TobleMiner/usb-pd-poe-extractor/USB-PD-PoE.kicad_pcb

## KiCad design USB-PD-PoE.kicad_pcb (2021-04-19)

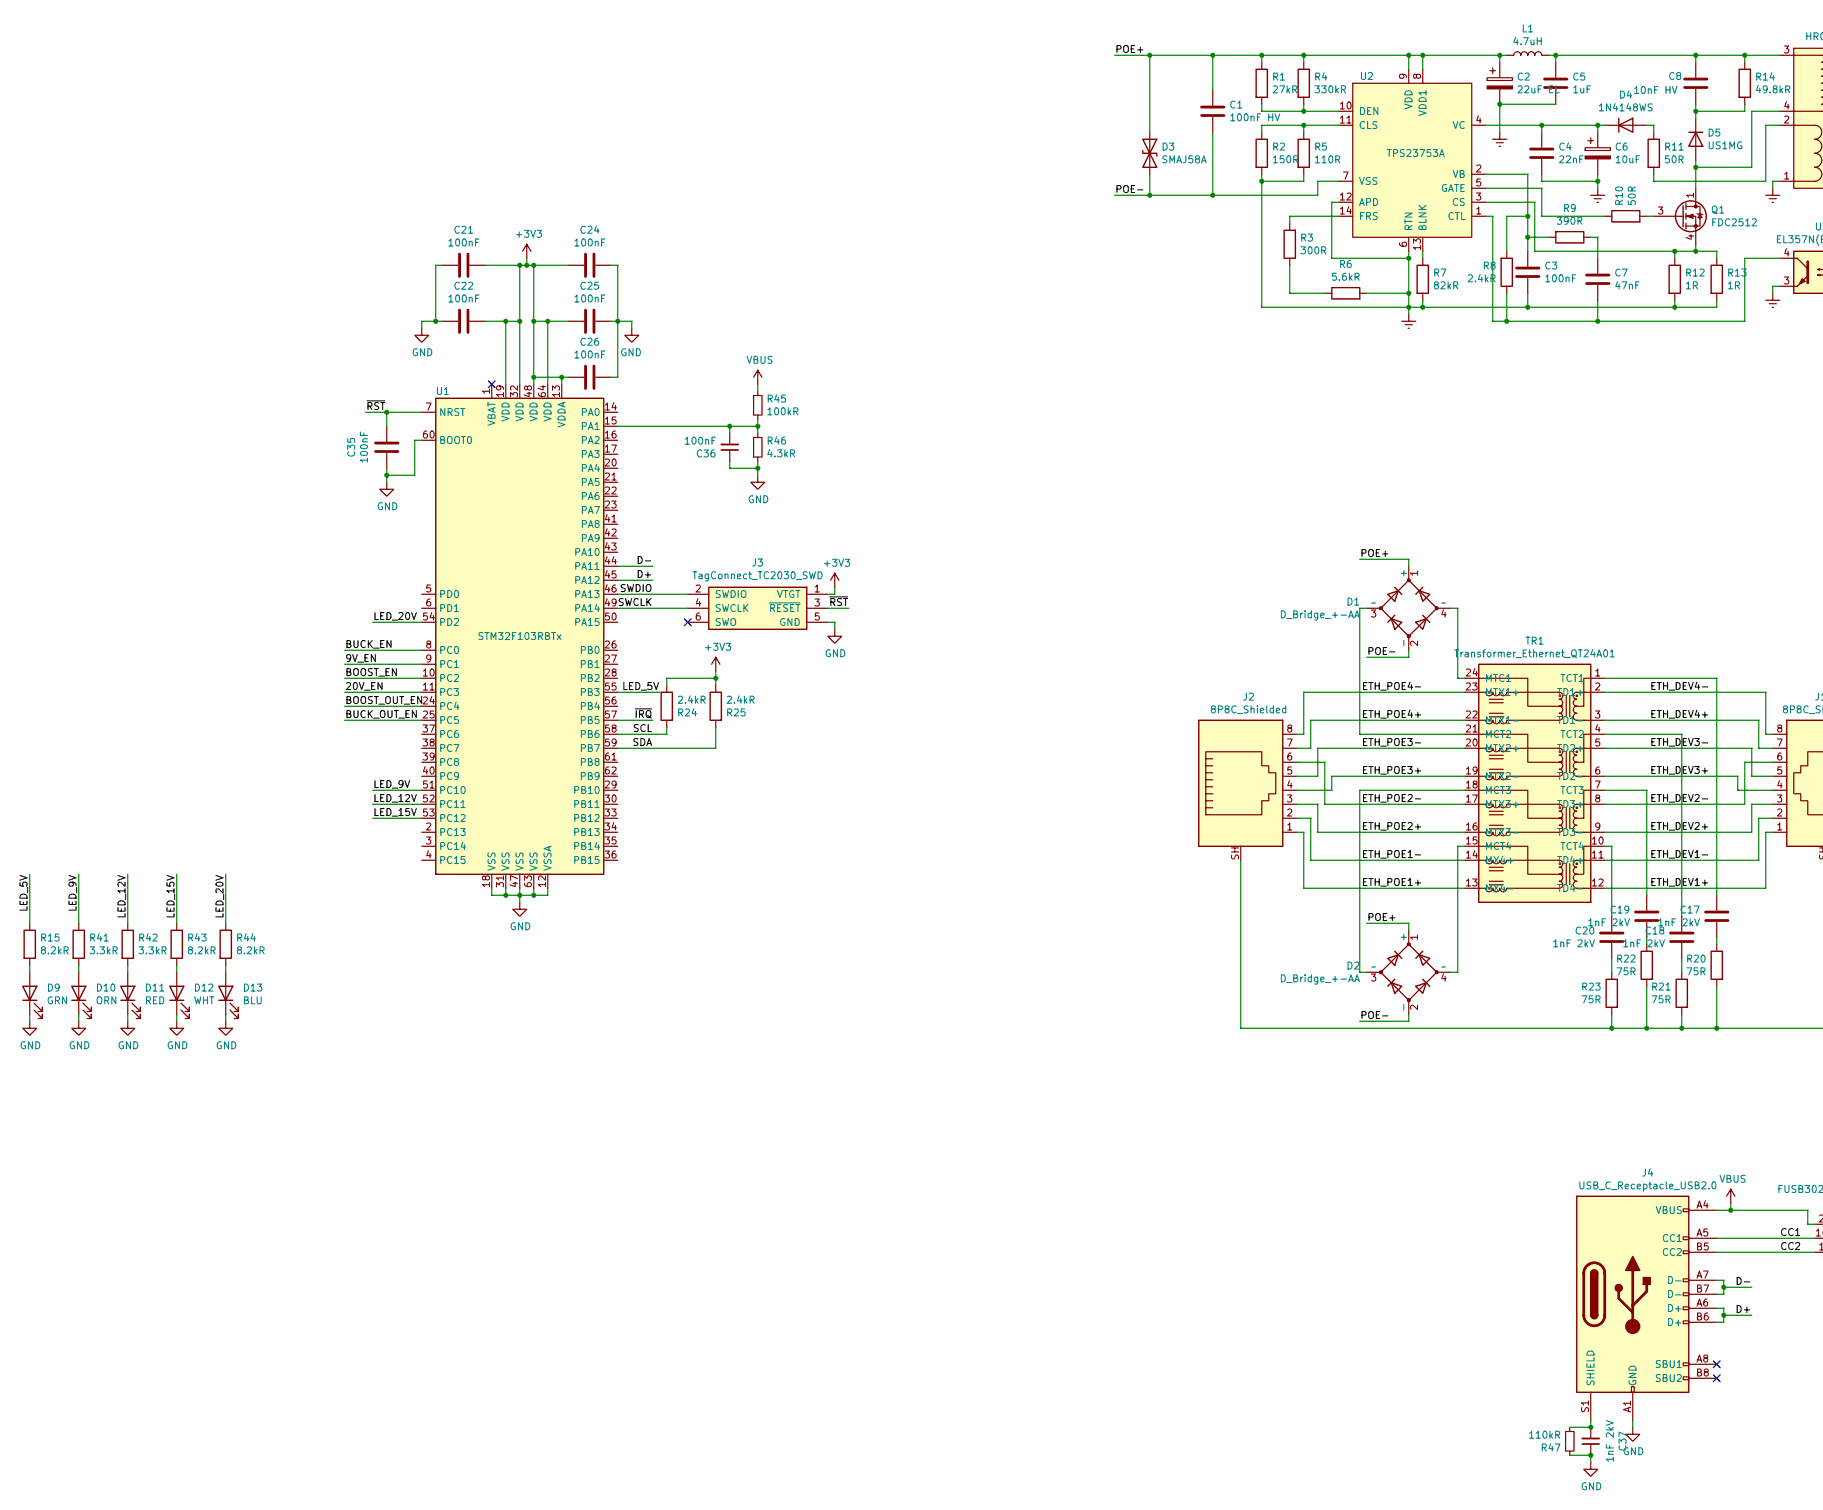
[picture p1: schematic USB-PD-PoE.sch, part in row 1, column 1]

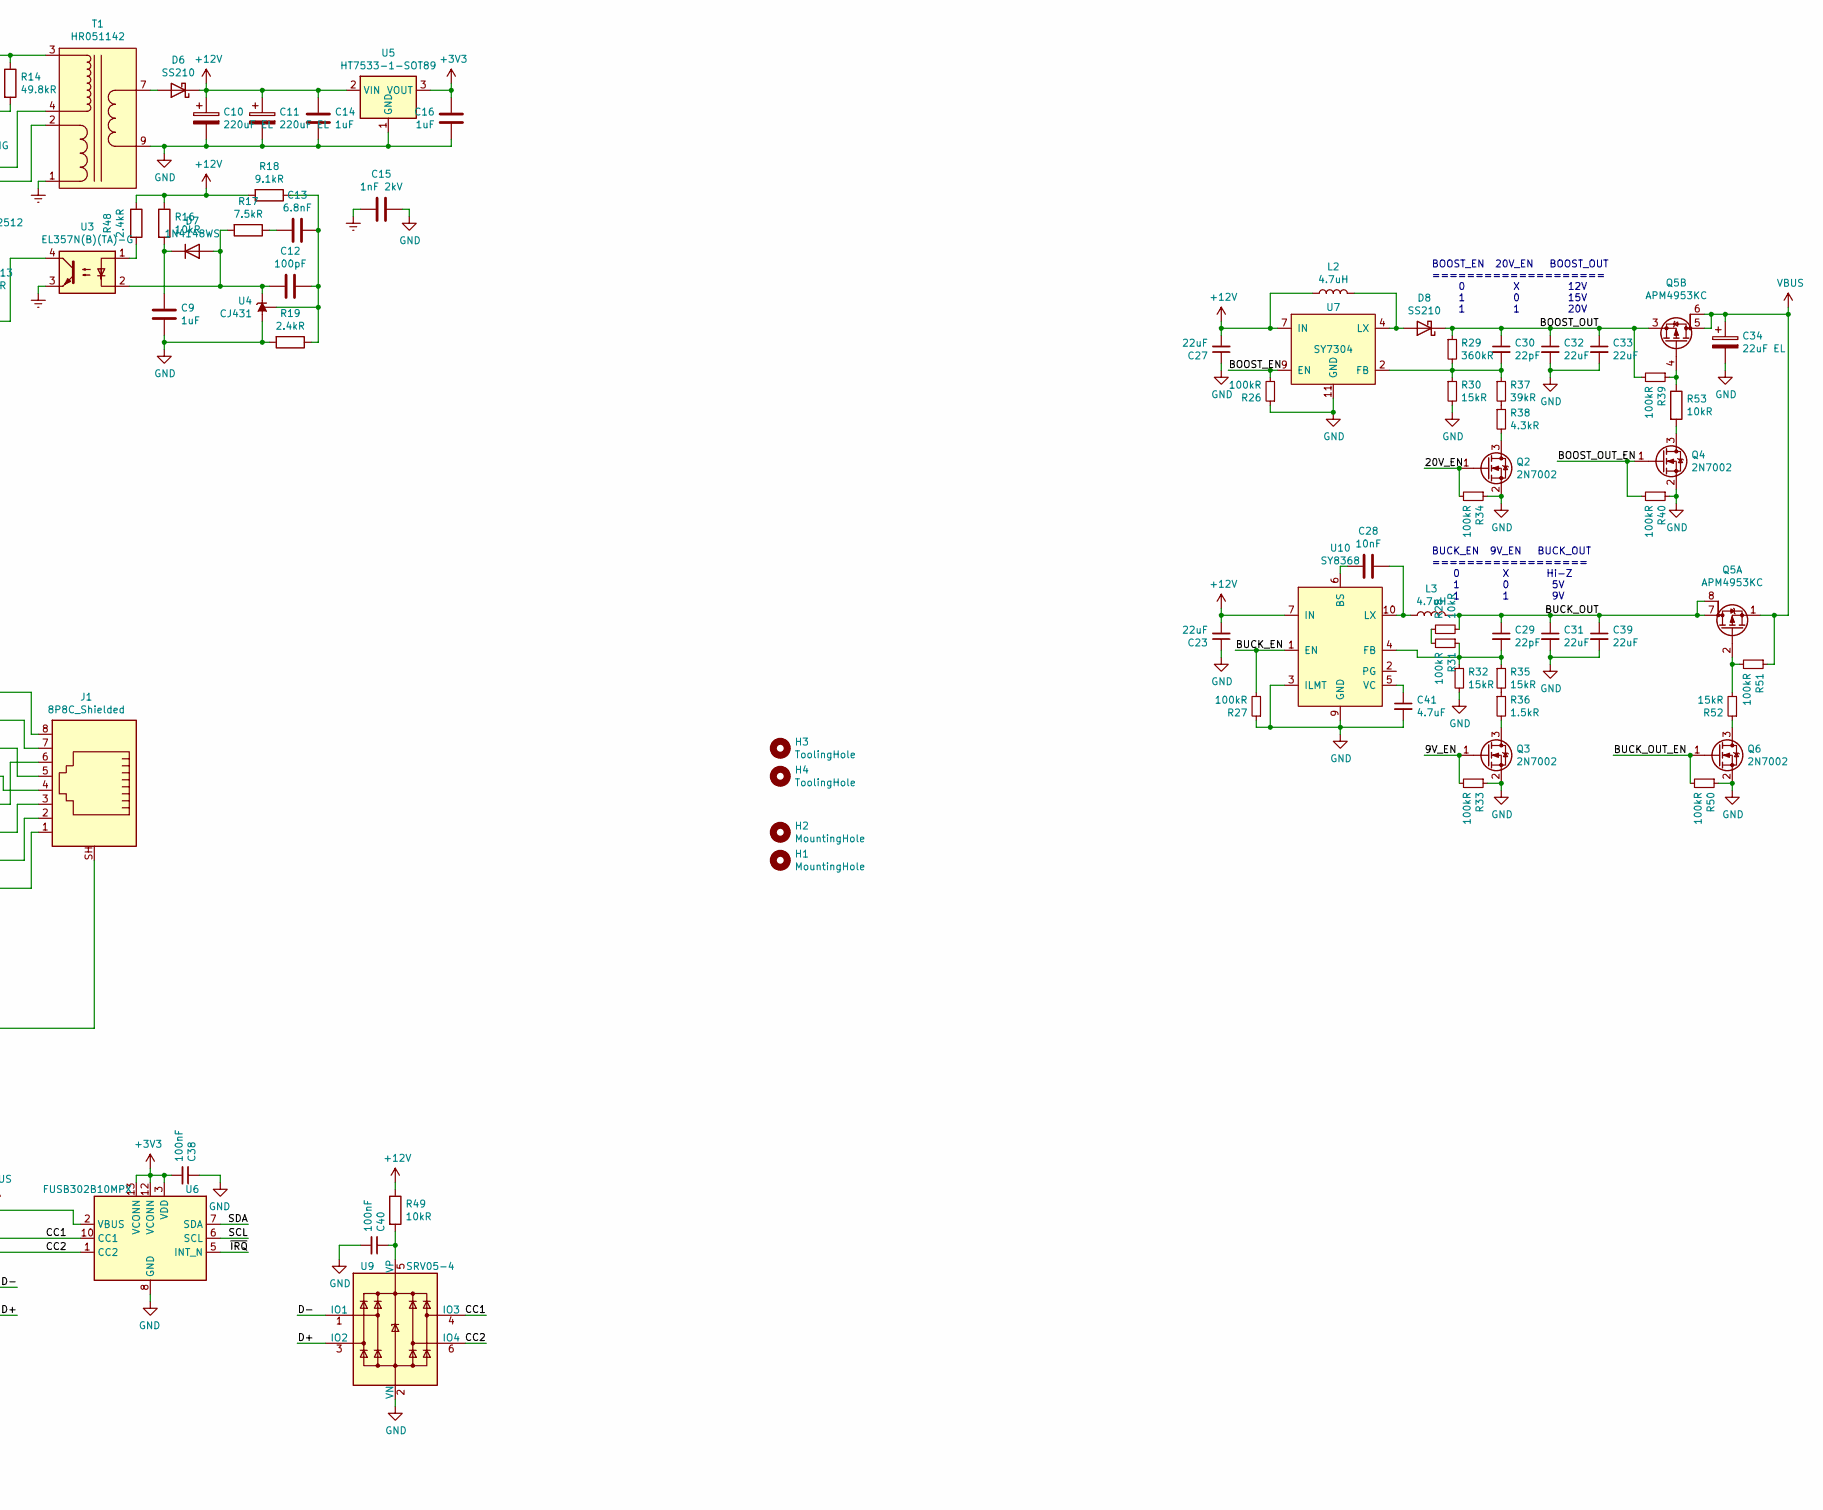
[picture p2: schematic USB-PD-PoE.sch, part in row 1, column 2]

Parts:
C1: 100nF HV; C_1206_3216Metric; LCSC C73745
C2, C34: 22uF EL; CP_Elec_6.3x7.7; LCSC C249868
C3, C21, C22, C24, C25, C26, C35, C36, C38, C40: 100nF; C_0402_1005Metric; LCSC C1525
C4: 22nF; C_0402_1005Metric; LCSC C1532
C5: 1uF; C_1206_3216Metric; LCSC C13832
C6: 10uF; CP_EIA-3216-10_Kemet-I; LCSC C7171
C7: 47nF; C_0603_1608Metric; LCSC C1622
C8: 10nF HV; C_0805_2012Metric; LCSC C18741
C9, C14, C16: 1uF; C_0402_1005Metric; LCSC C52923
C10, C11: 220uF EL; CP_Elec_6.3x7.7; LCSC C127327
C12: 100pF; C_0402_1005Metric; LCSC C1546
C13: 6.8nF; C_0402_1005Metric; LCSC C1542
C15, C17, C18, C19, C20, C37: 1nF 2kV; C_1206_3216Metric; LCSC C328909
C23, C27, C31, C32, C33, C39: 22uF; C_0805_2012Metric; LCSC C45783
C28: 10nF; C_0402_1005Metric; LCSC C15195
C29, C30: 22pF; C_0402_1005Metric; LCSC C1555
C41: 4.7uF; C_0402_1005Metric; LCSC C23733
D1, D2: D_Bridge_+-AA; TO-269AA; LCSC C2488
D3: SMAJ58A; D_SMA; LCSC C115922
D4, D7: 1N4148WS; D_SOD-323F; LCSC C2128
D5: US1MG; D_SMA; LCSC C412437
D6, D8: SS210; D_SMA; LCSC C14996
D9: GRN; LED_0603_1608Metric; LCSC C72043
D10: ORN; LED_0603_1608Metric; LCSC C72038
D11: RED; LED_0603_1608Metric; LCSC C2286
D12: WHT; LED_0603_1608Metric; LCSC C2290
D13: BLU; LED_0603_1608Metric; LCSC C72041
H1: MountingHole; MountingHole_3.2mm_M3
H2: MountingHole; MountingHole_3.2mm_M3_Pad_Via
H3, H4: ToolingHole; ToolingHole_JLCSMT
J1, J2: 8P8C_Shielded; Connector_8P8C_R-RJ45R08P-C000; LCSC C386757
J3: TagConnect_TC2030_SWD; Tag-Connect_TC2030-IDC-NL_2x03_P1.27mm_Vertical
J4: USB_C_Receptacle_USB2.0; USB_C_Receptacle_Palconn_UTC16-G; LCSC C165948
L1, L2, L3: 4.7uH; L_Bourns-SRN6028; LCSC C32684
Q1: FDC2512; SuperSOT-6; LCSC C154516
Q2, Q3, Q4, Q6: 2N7002; SOT-23; LCSC C8545
Q5: APM4953KC; SO-8_3.9x4.9mm_P1.27mm; LCSC C20897
R1: 27kR; R_0402_1005Metric; LCSC C25771
R2: 150R; R_0603_1608Metric; LCSC C22808
R3: 300R; R_0402_1005Metric; LCSC C25102
R4: 330kR; R_0402_1005Metric; LCSC C25778
R5: 110R; R_0603_1608Metric; LCSC C22781
R6: 5.6kR; R_0603_1608Metric; LCSC C25908
R7: 82kR; R_0603_1608Metric; LCSC C23254
R8, R19, R24, R25, R48: 2.4kR; R_0402_1005Metric; LCSC C25882
R9: 390R; R_0603_1608Metric; LCSC C23151
R10, R11: 50R; R_0603_1608Metric; LCSC C23185
R12, R13: 1R; R_0603_1608Metric; LCSC C22936
R14: 49.8kR; R_0603_1608Metric; LCSC C23184
R15, R43, R44: 8.2kR; R_0402_1005Metric; LCSC C25924
R16, R28, R49, R53: 10kR; R_0402_1005Metric; LCSC C25744
R17: 7.5kR; R_0402_1005Metric; LCSC C25918
R18: 9.1kR; R_0603_1608Metric; LCSC C23260
R20, R21, R22, R23: 75R; R_0402_1005Metric; LCSC C25133
R26, R27, R31, R33, R34, R39, R40, R45, R50, R51: 100kR; R_0402_1005Metric; LCSC C25741
R29: 360kR; R_0603_1608Metric; LCSC C23146
R30, R32, R35, R52: 15kR; R_0402_1005Metric; LCSC C25756
R36: 1.5kR; R_0402_1005Metric; LCSC C25867
R37: 39kR; R_0402_1005Metric; LCSC C25783
R38, R46: 4.3kR; R_0603_1608Metric; LCSC C23159
R41, R42: 3.3kR; R_0402_1005Metric; LCSC C25890
R47: 110kR; R_0603_1608Metric; LCSC C25805
T1: HR051142; LCSC C55680
TR1: Transformer_Ethernet_QT24A01; Transformer_Ethernet_TNK_QT24A01; LCSC C216359
U1: STM32F103RBTx; LQFP-64_10x10mm_P0.5mm; LCSC C46034
U2: TPS23753A; TSSOP-14_4.4x5mm_P0.65mm; LCSC C92115
U3: EL357N(B)(TA)-G; SOP-4_3.8x4.1mm_P2.54mm; LCSC C6649
U4: CJ431; SOT-23; LCSC C3113
U5: HT7533-1-SOT89; SOT-89-3; LCSC C14289
U6: FUSB302B10MPX; WQFN-14-1EP_2.5x2.5mm_P0.5mm_EP1.45x1.45mm; LCSC C132291
U7: SY7304; DFN-10-1EP_3x3mm_P0.5mm_EP1.55x2.48mm; LCSC C178252
U9: SRV05-4; SOT-23-6; LCSC C85364
U10: SY8368; QFN_3x3-10_SY8368; LCSC C125897

Connections:
+3V3: C16.1, C21.1, C22.1, C24.2, C25.2, C26.2, C38.2, J3.1 (VTGT), R24.1, R25.1, U1.13 (VDDA), U1.19 (VDD), U1.32 (VDD), U1.48 (VDD), U1.64 (VDD), U5.3 (VOUT), U6.3 (VDD), U6.4 (VDD), U6.12 (VCONN), U6.13 (VCONN)
+12V: C10.1, C11.1, C14.1, C23.2, C27.2, D6.1 (K), L2.1, R16.1, R18.2, R48.1, R49.1, U5.2 (VIN), U7.7 (IN), U10.7 (IN), U10.8 (IN)
/9V_EN: Q3.1 (G), R33.2, U1.9 (PC1)
/20V_EN: Q2.1 (G), R34.2, U1.11 (PC3)
/BOOST_EN: R26.2, U1.10 (PC2), U7.9 (EN)
/BOOST_OUT: C30.1, C32.1, C33.1, D8.1 (K), Q5.3 (S), R29.1, R39.2
/BOOST_OUT_EN: Q4.1 (G), R40.2, U1.24 (PC4)
/BUCK_EN: R27.2, U1.8 (PC0), U10.1 (EN)
/BUCK_OUT: C29.1, C31.1, C39.1, L3.2, Q5.7 (D), Q5.8 (G), R28.2
/BUCK_OUT_EN: Q6.1 (G), R50.2, U1.25 (PC5)
/CC1: J4.A5 (CC1), U6.10 (CC1), U6.11 (CC1), U9.4 (IO3)
/CC2: J4.B5 (CC2), U6.1 (CC2), U6.14 (CC2), U9.6 (IO4)
/D+: J4.A6 (D+), J4.B6 (D+), U1.45 (PA12), U9.3 (IO2)
/D-: J4.A7 (D-), J4.B7 (D-), U1.44 (PA11), U9.1 (IO1)
/ETH_DEV1+: J1.1, TR1.12 (TD4-)
/ETH_DEV1-: J1.2, TR1.11 (TD4+)
/ETH_DEV2+: J1.3, TR1.9 (TD3-)
/ETH_DEV2-: J1.6, TR1.8 (TD3+)
/ETH_DEV3+: J1.4, TR1.6 (TD2-)
/ETH_DEV3-: J1.5, TR1.5 (TD2+)
/ETH_DEV4+: J1.7, TR1.3 (TD1-)
/ETH_DEV4-: J1.8, TR1.2 (TD1+)
/ETH_POE1+: J2.1, TR1.13 (MX4-)
/ETH_POE1-: J2.2, TR1.14 (MX4+)
/ETH_POE2+: J2.3, TR1.16 (MTX3-)
/ETH_POE2-: J2.6, TR1.17 (MTX3+)
/ETH_POE3+: J2.4, TR1.19 (MTX2-)
/ETH_POE3-: J2.5, TR1.20 (MTX2+)
/ETH_POE4+: J2.7, TR1.22 (MTX1-)
/ETH_POE4-: J2.8, TR1.23 (MTX1+)
/LED_5V: R15.1, U1.55 (PB3)
/LED_9V: R41.1, U1.51 (PC10)
/LED_12V: R42.1, U1.52 (PC11)
/LED_15V: R43.1, U1.53 (PC12)
/LED_20V: R44.1, U1.54 (PD2)
/POE+: C1.1, C2.1, D1.1 (+), D2.1 (+), D3.1 (A1), L1.1, R1.1, R4.1, U2.8 (VDD1), U2.9 (VDD)
/POE-: C1.2, D1.2 (-), D2.2 (-), D3.2 (A2), U2.7 (VSS)
/SCL: R24.2, U1.58 (PB6), U6.6 (SCL)
/SDA: R25.2, U1.59 (PB7), U6.7 (SDA)
/SWCLK: J3.4 (SWCLK), U1.49 (PA14)
/SWDIO: J3.2 (SWDIO), U1.46 (PA13)
/~IRQ: U1.57 (PB5), U6.5 (INT_N)
/~RST: C35.1, J3.3 (~RESET), U1.7 (NRST)
Earth: C2.2, C3.2, C4.2, C5.2, C6.2, C15.2, R2.2, R5.2, R6.2, R7.2, R12.2, R13.2, T1.1, U2.6 (RTN), U2.12 (APD), U3.3
GND: C9.2, C10.2, C11.2, C14.2, C15.1, C16.2, C21.2, C22.2, C23.1, C24.1, C25.1, C26.1, C27.1, C31.2, C32.2, C33.2, C34.2, C35.2, C36.1, C37.1, C38.1, C39.2, C40.2, C41.2, D9.1 (K), D10.1 (K), D11.1 (K), D12.1 (K), D13.1 (K), J3.5 (GND), J4.A1 (GND), J4.A12 (GND), J4.B1 (GND), J4.B12 (GND), Q2.2 (S), Q3.2 (S), Q4.2 (S), Q6.2 (S), R19.2, R26.1, R27.1, R30.2, R32.2, R33.1, R34.1, R40.1, R46.2, R47.2, R50.1, T1.9, T1.10, U1.12 (VSSA), U1.18 (VSS), U1.31 (VSS), U1.47 (VSS), U1.60 (BOOT0), U1.63 (VSS), U4.3 (A), U5.1 (GND), U6.8 (GND), U6.9 (GND), U6.15 (GND), U7.11 (GND), U9.2 (VN), U10.3 (ILMT), U10.9 (GND)
unnamed: C3.1, R8.2, R9.2, U2.2 (VB)
unnamed: C4.1, C6.1, D4.1 (K), U2.4 (VC)
unnamed: C5.1, C8.1, L1.2, R14.1, T1.3
unnamed: C7.1, R9.1
unnamed: C7.2, R8.1, U2.1 (CTL), U3.4
unnamed: C8.2, D5.1 (K), R14.2
unnamed: C9.1, D7.1 (K), R16.2
unnamed: C12.1, C13.1, R18.1, R19.1, U4.1 (REF)
unnamed: C12.2, D7.2 (A), R17.2, U3.2, U4.2 (K)
unnamed: C13.2, R17.1
unnamed: C17.1, R20.1
unnamed: C17.2, TR1.1 (TCT1)
unnamed: C18.1, R21.1
unnamed: C18.2, TR1.4 (TCT2)
unnamed: C19.1, R22.1
unnamed: C19.2, TR1.7 (TCT3)
unnamed: C20.1, R23.1
unnamed: C20.2, TR1.10 (TCT4)
unnamed: C28.1, L3.1, U10.10 (LX)
unnamed: C28.2, U10.6 (BS)
unnamed: C29.2, R31.1, R32.1, R35.1, U10.4 (FB)
unnamed: C30.2, R29.2, R30.1, R37.1, U7.2 (FB)
unnamed: C36.2, R45.2, R46.1, U1.15 (PA1)
unnamed: C37.2, J4.S1 (SHIELD), R47.1
unnamed: C40.1, R49.2, U9.5 (VP)
unnamed: C41.1, U10.5 (VC)
unnamed: D1.3 (~~), TR1.21 (MCT2)
unnamed: D1.4 (~~), TR1.24 (MTC1)
unnamed: D2.3 (~~), TR1.18 (MCT3)
unnamed: D2.4 (~~), TR1.15 (MCT4)
unnamed: D4.2 (A), R11.1
unnamed: D5.2 (A), Q1.1 (D), Q1.2 (D), Q1.5 (D), Q1.6 (D), T1.4
unnamed: D6.2 (A), T1.7, T1.8
unnamed: D8.2 (A), L2.2, U7.4 (LX), U7.5 (LX)
unnamed: D9.2 (A), R15.2
unnamed: D10.2 (A), R41.2
unnamed: D11.2 (A), R42.2
unnamed: D12.2 (A), R43.2
unnamed: D13.2 (A), R44.2
unnamed: J1.SH, J2.SH, R20.2, R21.2, R22.2, R23.2
unnamed: Q1.3 (G), R10.2
unnamed: Q1.4 (S), R12.1, R13.1, U2.3 (CS)
unnamed: Q2.3 (D), R38.2
unnamed: Q3.3 (D), R36.2
unnamed: Q4.3 (D), R53.2
unnamed: Q5.2 (G), R51.2, R52.2
unnamed: Q5.4 (G), R39.1, R53.1
unnamed: Q6.3 (D), R52.1
unnamed: R1.2, R4.2, U2.10 (DEN)
unnamed: R2.1, R5.1, U2.11 (CLS)
unnamed: R3.1, R6.1
unnamed: R3.2, U2.14 (FRS)
unnamed: R7.1, U2.13 (BLNK)
unnamed: R10.1, U2.5 (GATE)
unnamed: R11.2, T1.2
unnamed: R28.1, R31.2
unnamed: R35.2, R36.1
unnamed: R37.2, R38.1
unnamed: R48.2, U3.1
VBUS: C34.1, J4.A4 (VBUS), J4.A9 (VBUS), J4.B4 (VBUS), J4.B9 (VBUS), Q5.1 (S), Q5.5 (D), Q5.6 (G), R45.1, R51.1, U6.2 (VBUS)

Notes on the sheet:
BOOST_EN 20V_EN BOOST_OUT ==================== 0 X 12V 1 0 15V 1 1 20V
BUCK_EN 9V_EN BUCK_OUT ================== 0 X Hi-Z 1 0 5V 1 1 9V

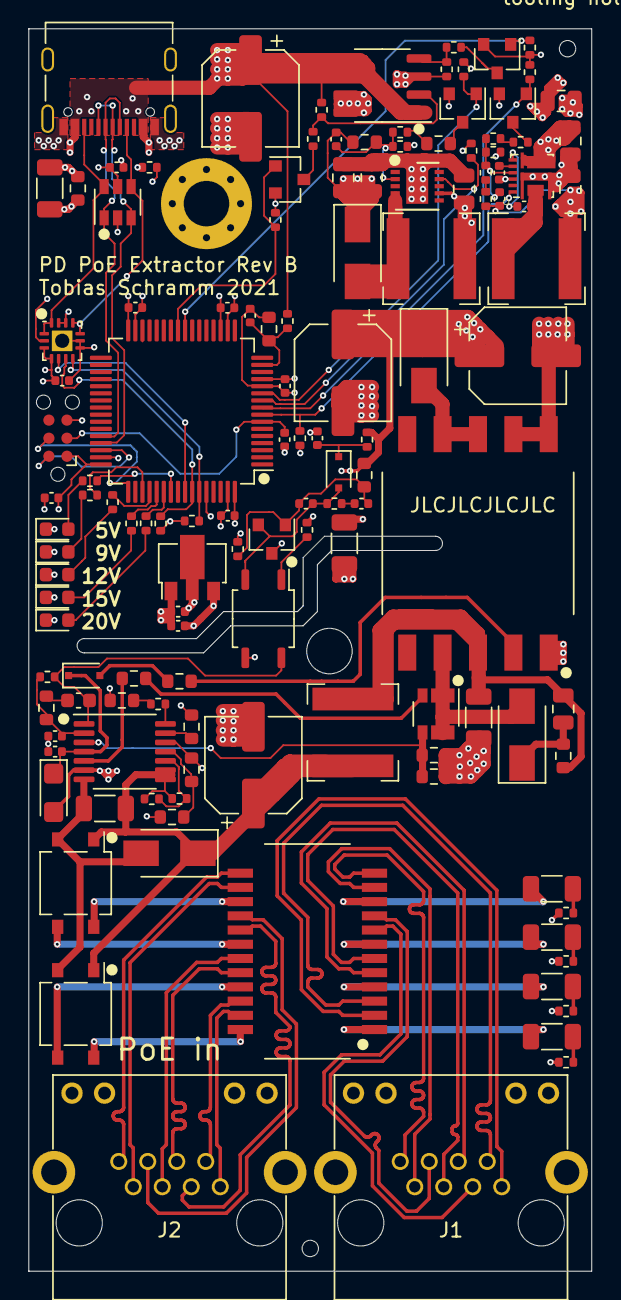
[picture p3: board USB-PD-PoE.kicad_pcb from above]

Board: 4 copper layers, 39.6 x 87.4 mm, 135 parts (0 on the bottom side), 105 nets.
