TobleMiner/usb-pd-poe-extractor/(commit log)

2021-03-08 Hide footprint references
    [USB-PD-PoE.kicad_pcb]
2021-03-08 Add tooling holes
    [USB-PD-PoE.kicad_pcb, USB-PD-PoE.sch]
2021-03-08 Fix PA <-> PB mixup
    [USB-PD-PoE.kicad_pcb, USB-PD-PoE.sch]
2021-03-08 Fix GND copper zone clearance issues
    [USB-PD-PoE.kicad_pcb]
2021-03-08 Center silkscreen designator alignment
    [USB-PD-PoE.kicad_pcb]
2021-03-08 Remove GND fill below L2 and L3
    [USB-PD-PoE.kicad_pcb]
2021-03-08 Improve VBUS current carrying capability
    [USB-PD-PoE.kicad_pcb]
2021-03-08 Protect screw holes from layer shorts
    [USB-PD-PoE.kicad_pcb, USB-PD-PoE.sch]
2021-03-08 Add USB/CC protection diode
    [USB-PD-PoE.kicad_pcb, USB-PD-PoE.sch]
2021-03-08 Remove +12V stub
    [USB-PD-PoE.kicad_pcb]
2021-03-08 Hide USB TVS silkscreen reference
    [USB-PD-PoE.kicad_pcb]
2021-03-08 Add pin 1 indicator to USB TVS
    [USB-PD-PoE.kicad_pcb]
2021-04-10 Fix reversed CJ431 pinout
    [USB-PD-PoE.kicad_pcb, USB-PD-PoE.sch]
2021-04-10 Add more bulk capacitance on flyback output
    [USB-PD-PoE.sch]
2021-04-10 Add buck converter power gating
    [USB-PD-PoE.kicad_pcb, USB-PD-PoE.sch]
2021-04-10 Move 5V LED away from JTAG pins
    [USB-PD-PoE.kicad_pcb, USB-PD-PoE.sch]
2021-04-11 Fix ethernet transformer footprint
    [USB-PD-PoE.kicad_pcb, USB-PD-PoE.sch]
2021-04-19 Add Silergy SY8368 synchronous step-down regulator
2021-04-19 Optimize design for manufacturing
    Replace components not available at JLC anymore.
    [USB-PD-PoE.kicad_pcb, USB-PD-PoE.sch]
